sparkfunX/Qwiic_RF/README.md

# Qwiic_RF
LoRa Radio for the Qwiic System
