sparkfunX/Qwiic_RF/Hardware/Production/ordering_instructions.txt

panel size, 135x109mm
PCB thickness, 0.8mm
number of layers, 2
soldermask color, Black
silkscreen color, White
oz copper, 1oz
finish, HASL lead free
stencils, top
pcs per panel, 4
