sparkfunX/Qwiic_RF/Hardware/Test_Platform/Production/ordering_instructions.txt

panel size, 91x91mm
PCB thickness, 1.6mm
number of layers, 2
soldermask color, Black
silkscreen color, White
oz copper, 1oz
finish, HASL lead free
stencils, top+bottom
