sparkfunX/Qwiic_RF/Hardware/Test_Platform/README.md

** Test Platform for Qwiic LoRa **

This is essentially the prototype Qwiic LoRa hardware with only a U.FL connector for testing modular antennas for integration.
