sparkfunX/Qwiic_RF/Hardware/Qwiic_LoRa.pdf

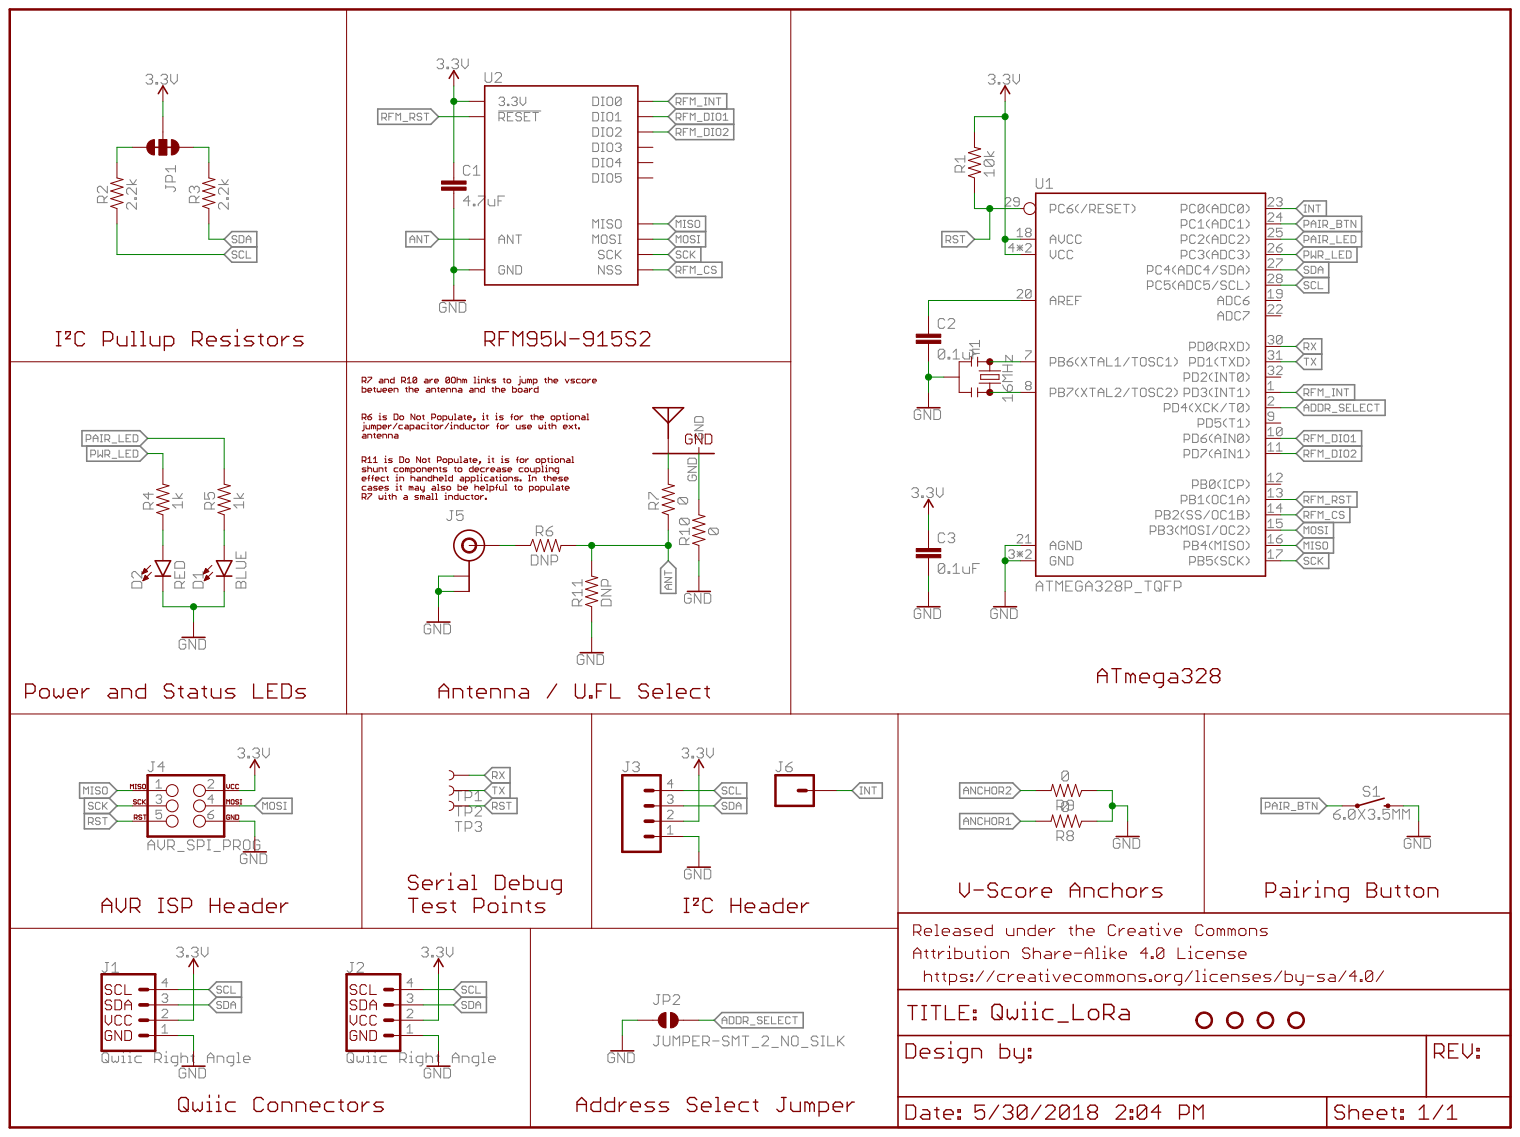
[picture p1: page 1]
