sparkfunX/Qwiic_RF/Hardware/Qwiic_LoRa.brd

## EAGLE design Hardware/Qwiic_LoRa.brd (2018-06-28)

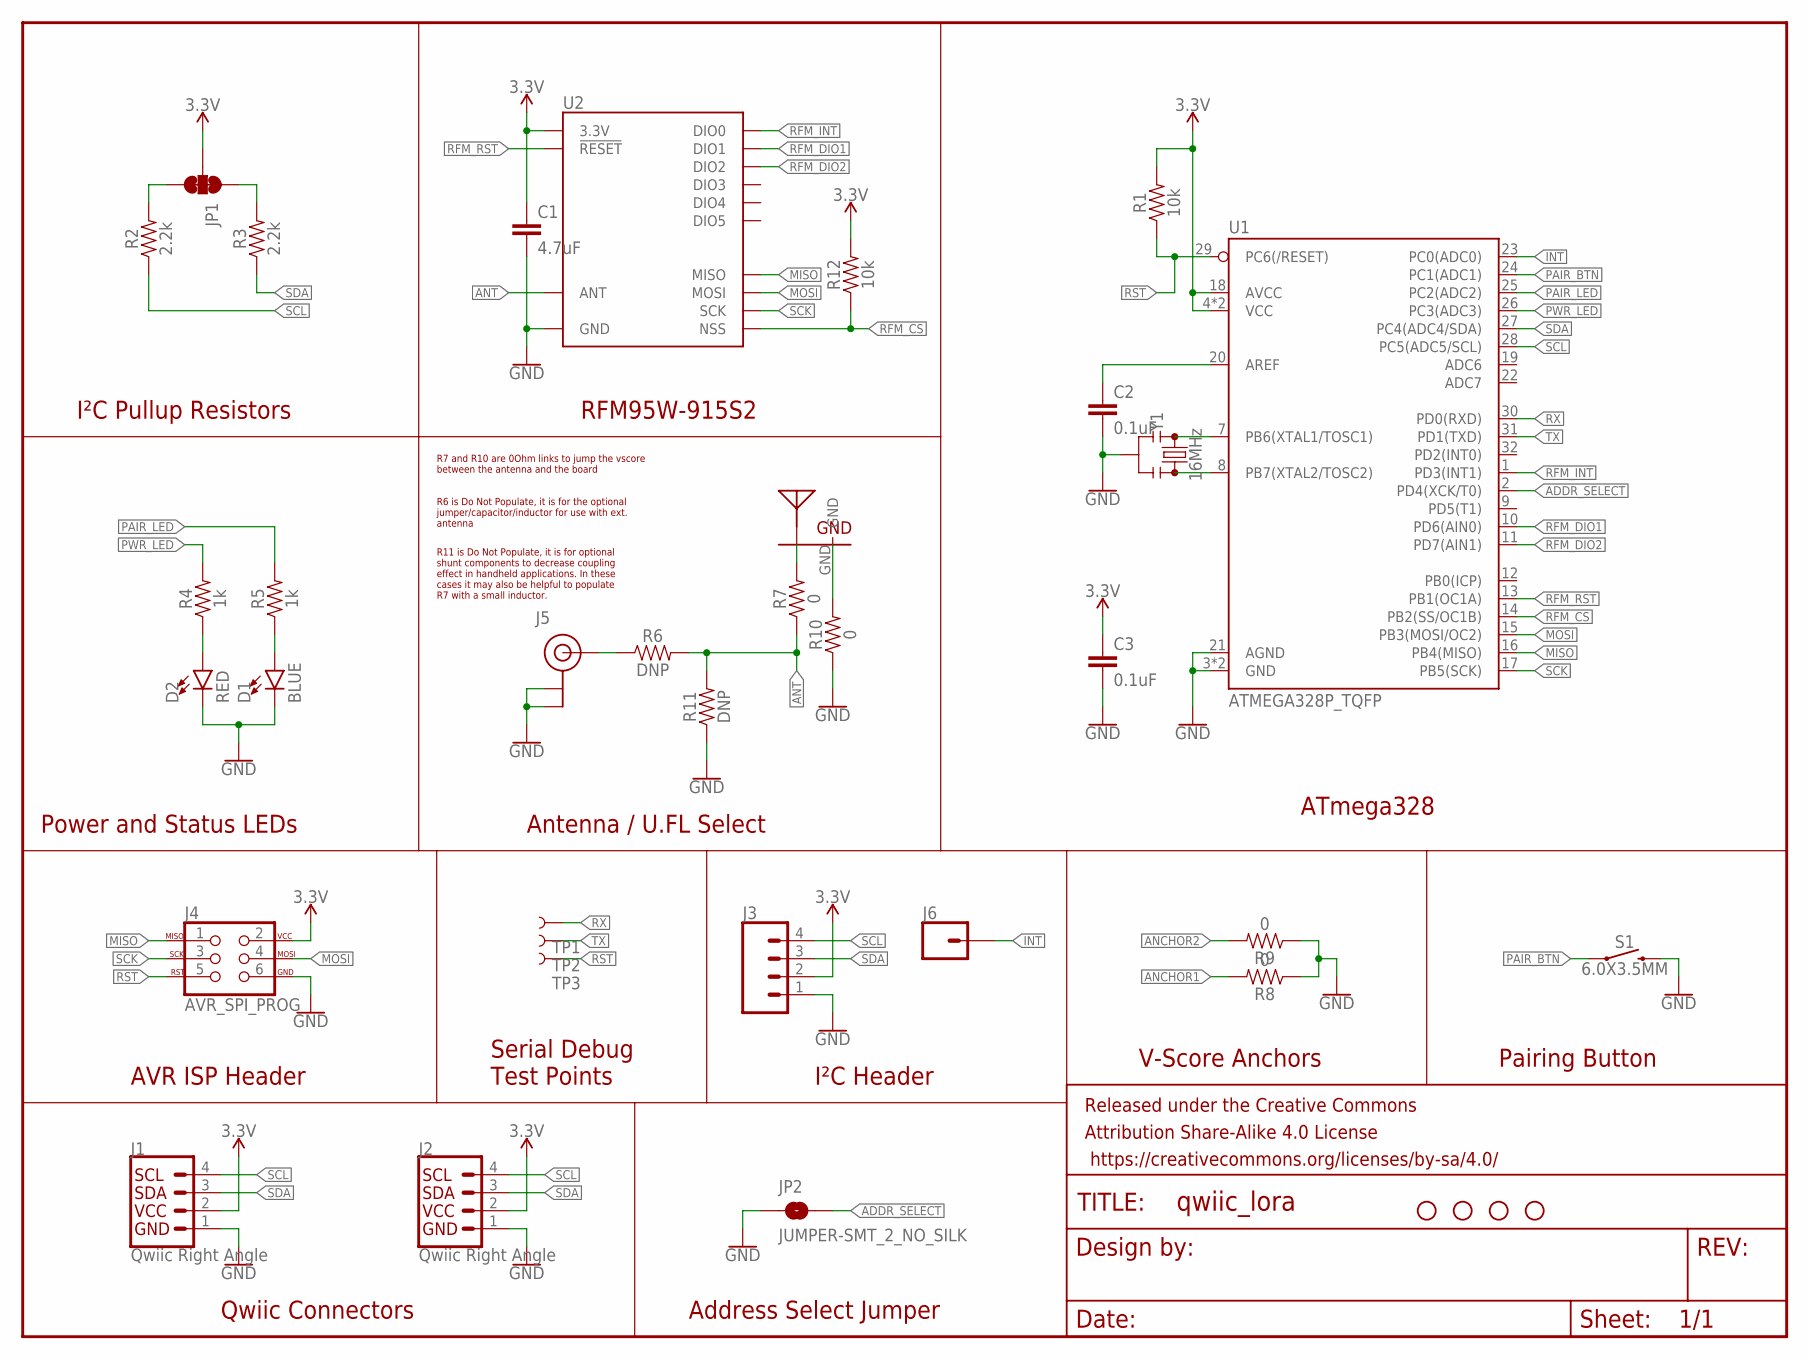
[picture p2: schematic Qwiic_LoRa.sch]

Parts:
C1: 4.7uF; 0603
C2, C3: 0.1uF; 0603
D1: BLUE; LED-0603
D2: RED; LED-0603
FRAME1: FRAME-LETTER; CREATIVE_COMMONS
H1, H2, H3, H4: STAND-OFF
J1, J2: Qwiic Right Angle; 1X04_1MM_RA
J3: CONN_041X04_NO_SILK; 1X04_NO_SILK
J4: AVR_SPI_PROG; 2X3_TEST_POINTS
J5: U.FL
J6: CONN_01PTH_NO_SILK_YES_STOP; 1X01_NO_SILK
JP1: JUMPER-SMT_3_2-NC_TRACE_SILK; SMT-JUMPER_3_2-NC_TRACE_SILK
JP2: JUMPER-SMT_2_NO_SILK; SMT-JUMPER_2_NO_SILK
R1, R12: 10k; 0603
R2, R3: 2.2k; 0603
R4, R5: 1k; 0603
R6, R11: DNP; 0603
R7, R8, R9, R10: 0; 0603
S1: 6.0X3.5MM; TACTILE_SWITCH_SMD_6.0X3.5MM
TP1, TP2, TP3: TEST-POINT3; PAD.03X.03
U1: ATMEGA328P_TQFP; TQFP32-08
U2: RFM96W; RFM95/96/97/98W
U$1: ANTENNA_915MHZ_INVERTED_F; ANTENNA_INVERTED_F_915MHZ
Y1: 16MHz; RESONATOR-SMD-3.2X1.3

Connections:
3.3V: C1.1, C3.1, J1.2, J2.2, J3.2, J4.2, JP1.2, R1.2, R12.2, U1.4 (VCC), U1.6 (VCC), U1.18 (AVCC), U2.3.3V
ADDR_SELECT: JP2.2, U1.2 (PD4(XCK/T0))
ANCHOR1: R8.2
ANCHOR2: R9.2
ANT: R6.2, R7.1, R11.2, U2.ANT
GND: C1.2, C2.2, C3.2, D1.C, D2.C, J1.1, J2.1, J3.1, J4.6, J5.1 (GND), J5.2 (GND), JP2.1, R8.1, R9.1, R10.1, R11.1, S1.2, U1.3 (GND), U1.5 (GND), U1.21 (AGND), U2.GND@1 (GND), U2.GND@2 (GND), U2.GND@3 (GND), Y1.2
INT: J6.1, U1.23 (PC0(ADC0))
MISO: J4.1, U1.16 (PB4(MISO)), U2.MISO
MOSI: J4.4, U1.15 (PB3(MOSI/OC2)), U2.MOSI
unnamed: D2.A, R4.1
unnamed: D1.A, R5.1
unnamed: C2.1, U1.20 (AREF)
unnamed: U1.7 (PB6(XTAL1/TOSC1)), Y1.1
unnamed: U1.8 (PB7(XTAL2/TOSC2)), Y1.3
unnamed: R7.2, U$1.FEED
unnamed: JP1.1, R3.2
unnamed: JP1.3, R2.2
unnamed: J5.FEED (SIGNAL), R6.1
unnamed: R10.2, U$1.GND
PAIR_BTN: S1.1, U1.24 (PC1(ADC1))
PAIR_LED: R5.2, U1.25 (PC2(ADC2))
PWR_LED: R4.2, U1.26 (PC3(ADC3))
RFM_CS: R12.1, U1.14 (PB2(SS/OC1B)), U2.NSS
RFM_DIO1: U1.10 (PD6(AIN0)), U2.DIO1
RFM_DIO2: U1.11 (PD7(AIN1)), U2.DIO2
RFM_INT: U1.1 (PD3(INT1)), U2.DIO0
RFM_RST: U1.13 (PB1(OC1A)), U2.!RESET
RST: J4.5, R1.1, TP3.P$1, U1.29 (PC6(/RESET))
RX: TP1.P$1, U1.30 (PD0(RXD))
SCK: J4.3, U1.17 (PB5(SCK)), U2.SCK
SCL: J1.4, J2.4, J3.4, R2.1, U1.28 (PC5(ADC5/SCL))
SDA: J1.3, J2.3, J3.3, R3.1, U1.27 (PC4(ADC4/SDA))
TX: TP2.P$1, U1.31 (PD1(TXD))

Notes on the sheet:
ATmega328
RFM95W-915S2
I²C Pullup Resistors
Antenna / U.FL Select
Power and Status LEDs
Qwiic Connectors
I²C Header
V-Score Anchors
Pairing Button
AVR ISP Header
Address Select Jumper
R7 and R10 are 0Ohm links to jump the vscore between the antenna and the board
R6 is Do Not Populate, it is for the optional jumper/capacitor/inductor for use with ext. antenna
R11 is Do Not Populate, it is for optional shunt components to decrease coupling effect in handheld applications. In these cases it may also be helpful to populate R7 with a small inductor.
Serial Debug Test Points

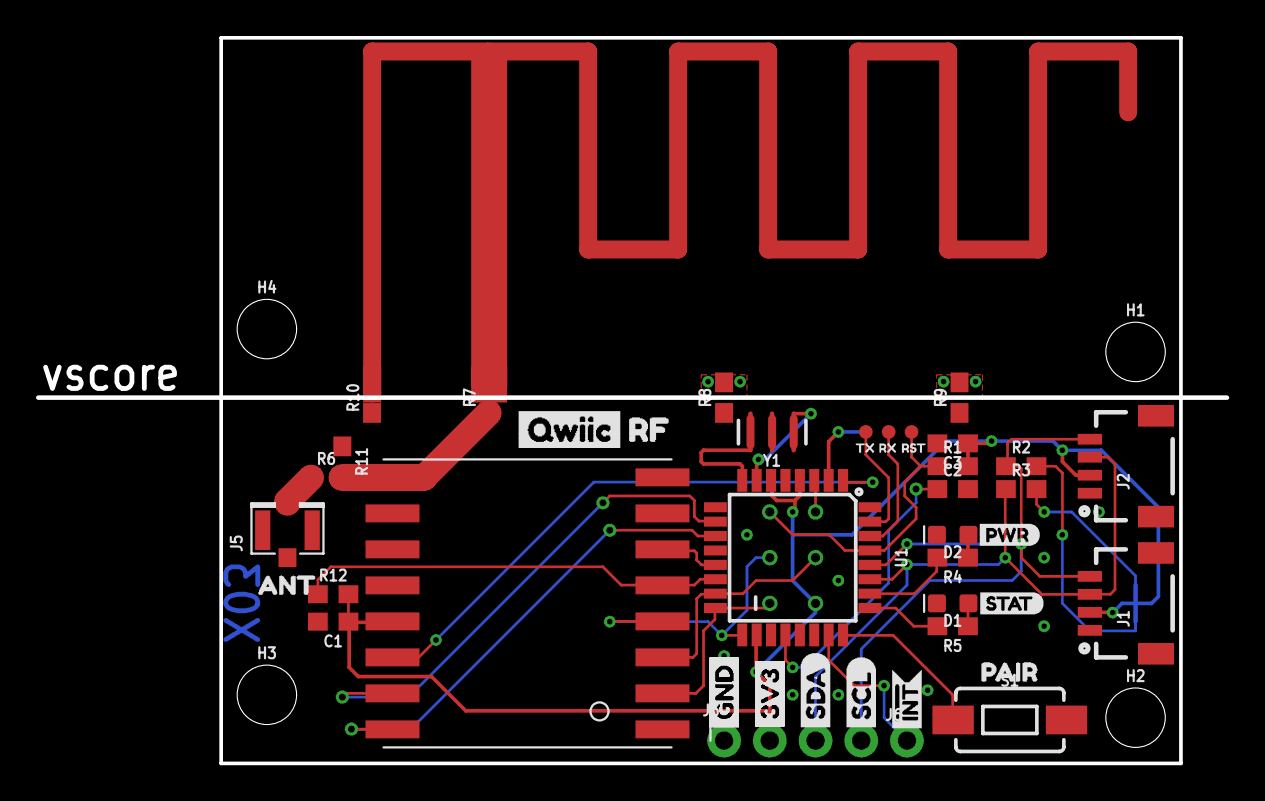
[picture p3: board Qwiic_LoRa.brd from above]

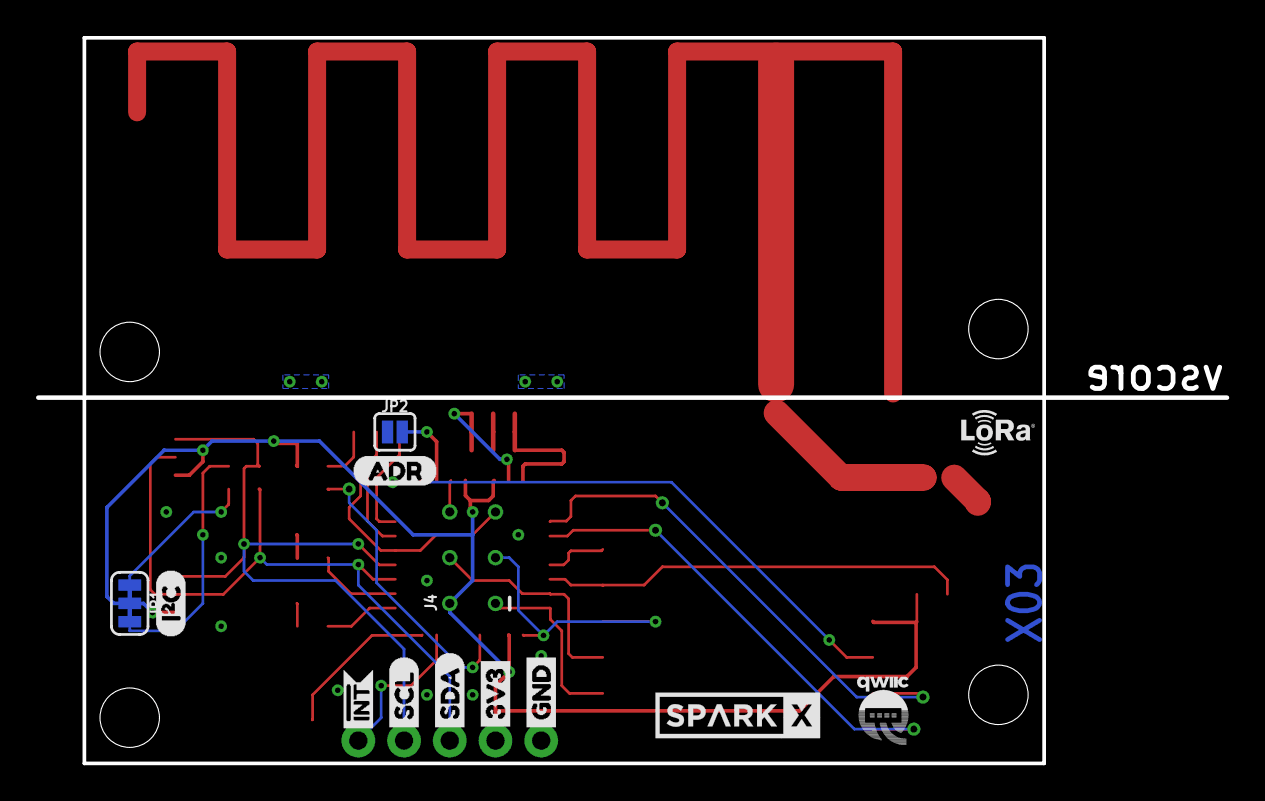
[picture p4: board Qwiic_LoRa.brd from below]

Board: 2 copper layers, 53.3 x 40.3 mm, 65 parts (13 on the bottom side), 31 nets.

Other parts of the board:
U$2: ANT0
U$3: PAIR1
U$4, U$22: SDA-[)
U$5, U$23: SCL-[)
U$6, U$18, U$19: GND-04
U$7, U$20, U$21: 3V3-04
U$8: PWR1
U$9: STAT2
U$10: QWIIC-LOGO-SMALL
U$11: TX1
U$12, U$24: INT#-[<
U$13: SPARKX-MEDIUM
U$14: ADR-()
U$15: RF1
U$16: QWIIC0
U$17: LORA_MARK#PNG
U$25: I_SUPER2_C-()-04
U$26: PRODUCTION_INSTRUCTIONS
U$27: RX0
U$28: RST2
