sparkfunX/Qwiic_RF/Hardware/Antennas/StubTrace/StubTrace_Antenna.brd

## EAGLE design Hardware/Antennas/StubTrace/StubTrace_Antenna.brd (2018-04-12)

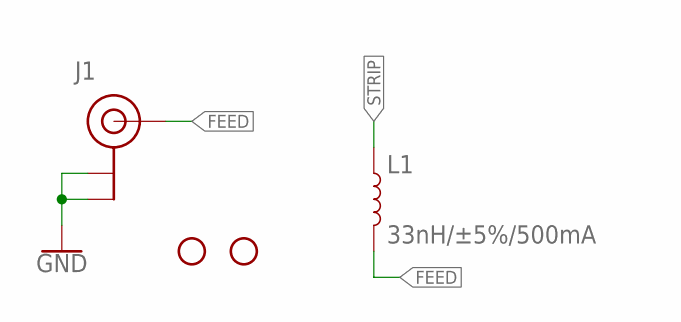
[picture p5: schematic StubTrace_Antenna.sch]

Parts:
H1, H2: STAND-OFF
J1: U.FL
L1: 33nH/±5%/500mA; 0603

Connections:
FEED: J1.FEED (SIGNAL), L1.2
GND: J1.1 (GND), J1.2 (GND)
STRIP: L1.1

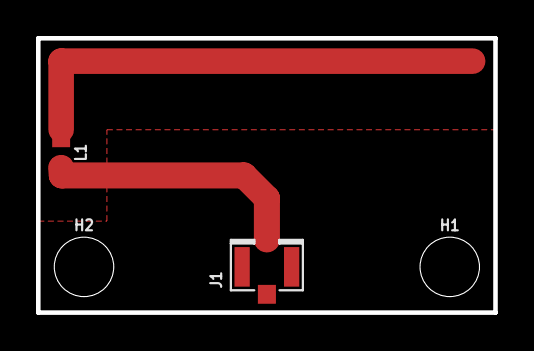
[picture p6: board StubTrace_Antenna.brd from above]

Board: 2 copper layers, 25.4 x 15.2 mm, 4 parts (0 on the bottom side), 2 nets.
