sparkfunX/Qwiic_RF/Hardware/Antennas/InvertedF/InvertedF_Antenna.brd

## EAGLE design Hardware/Antennas/InvertedF/InvertedF_Antenna.brd (2018-04-12)

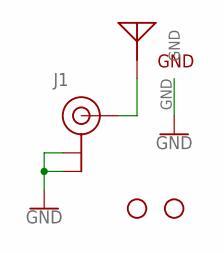
[picture p7: schematic InvertedF_Antenna.sch]

Parts:
H1, H2: STAND-OFF
J1: U.FL
U$1: ANTENNA_915MHZ_INVERTED_F; ANTENNA_INVERTED_F_915MHZ

Connections:
FEED: J1.FEED (SIGNAL), U$1.FEED
GND: J1.1 (GND), J1.2 (GND), U$1.GND

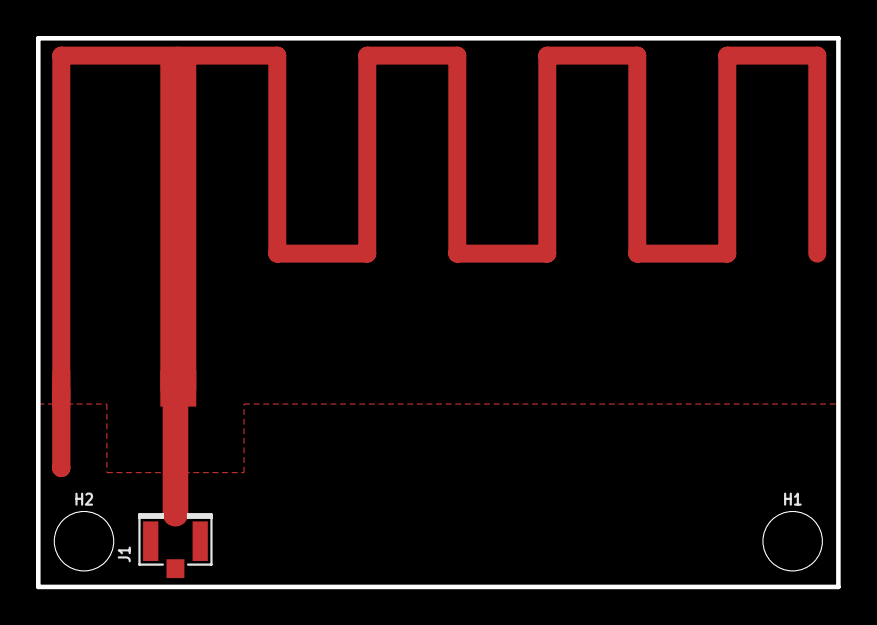
[picture p8: board InvertedF_Antenna.brd from above]

Board: 2 copper layers, 44.5 x 30.5 mm, 4 parts (0 on the bottom side), 2 nets.
