sparkfunX/Qwiic_RF/Hardware/Test_Platform/Qwiic_RF.brd

## EAGLE design Hardware/Test_Platform/Qwiic_RF.brd (2018-04-12)

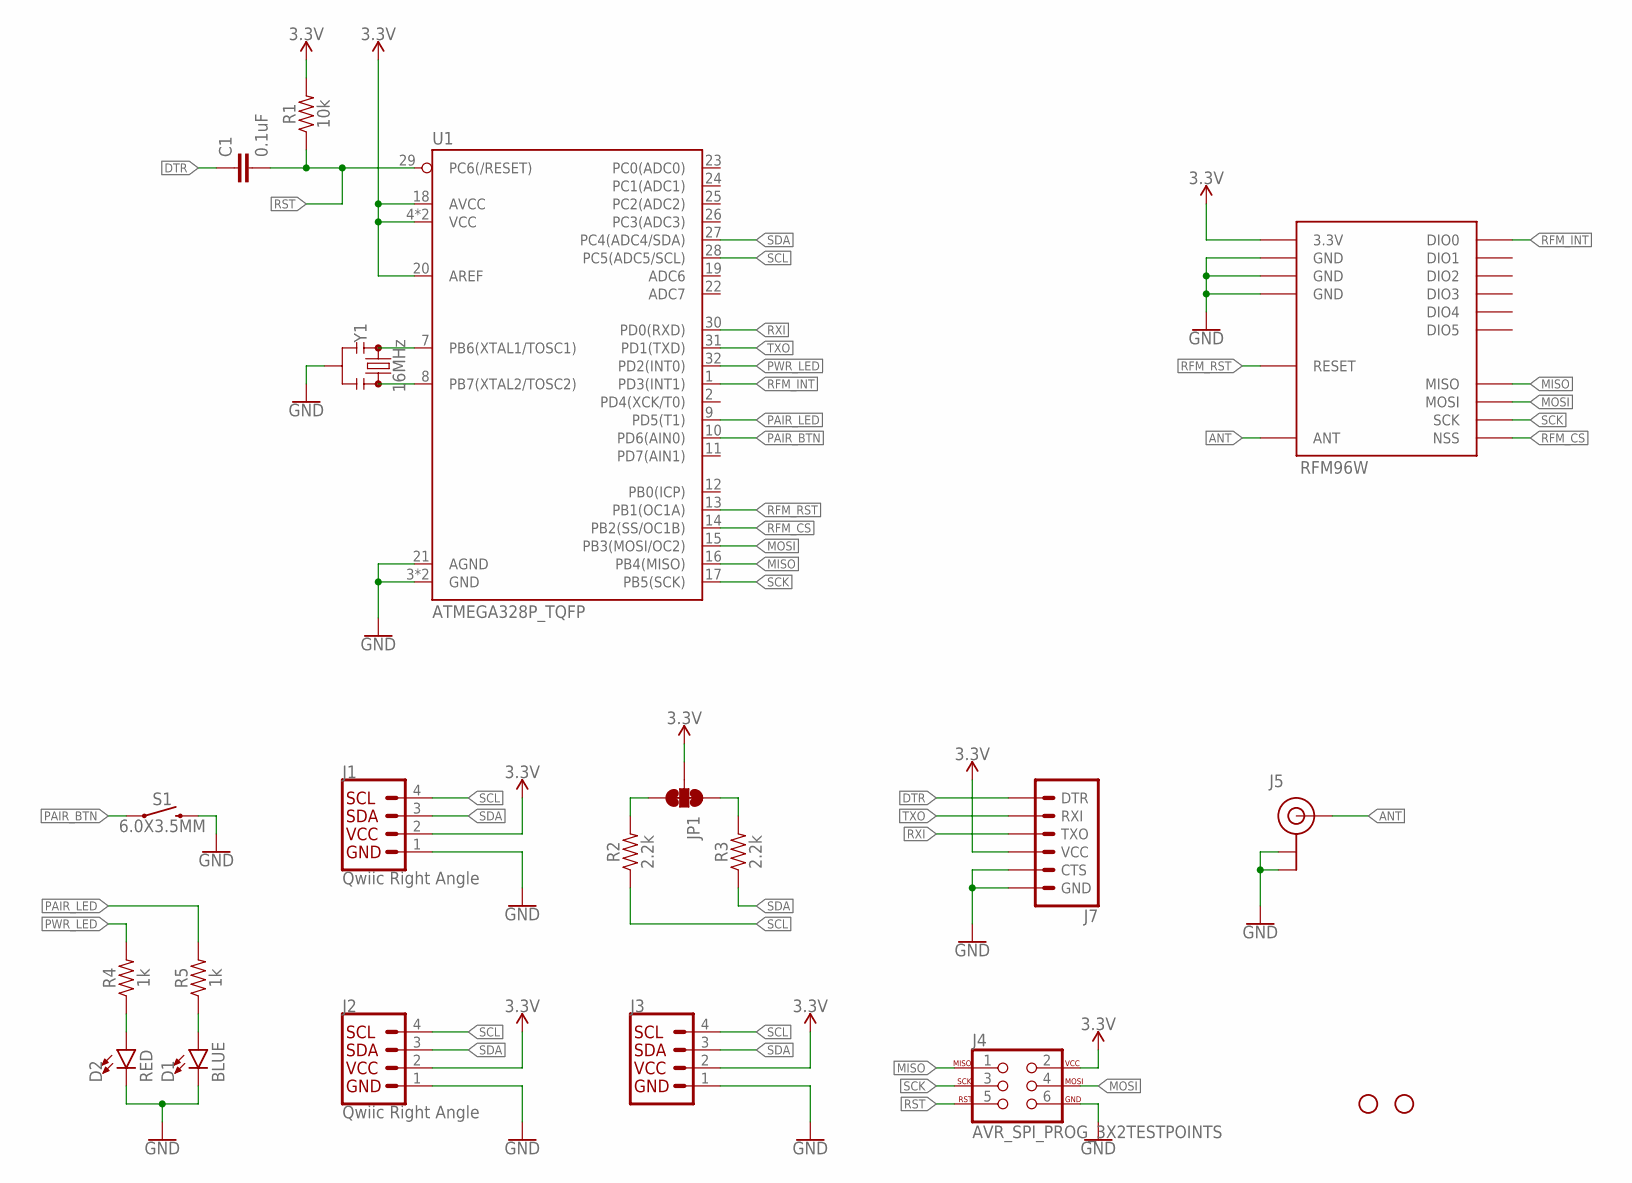
[picture p9: schematic Qwiic_RF.sch]

Parts:
C1: 0.1uF; 0603
D1: BLUE; LED-0603
D2: RED; LED-0603
H1, H2: STAND-OFF
J1, J2: Qwiic Right Angle; 1X04_1MM_RA
J3: I2C_STANDARD; 1X04
J4: AVR_SPI_PROG_3X2TESTPOINTS; 2X3_TEST_POINTS
J5: U.FL
J7: 6_PIN_SERIAL_TARGET; 1X06
JP1: JUMPER-SMT_3_2-NC_TRACE_SILK; SMT-JUMPER_3_2-NC_TRACE_SILK
R1: 10k; 0603
R2, R3: 2.2k; 0603
R4, R5: 1k; 0603
RFM96W: RFM96W; RFM95/96/97/98W
S1: 6.0X3.5MM; TACTILE_SWITCH_SMD_6.0X3.5MM
U1: ATMEGA328P_TQFP; TQFP32-08
Y1: 16MHz; RESONATOR-SMD-3.2X1.3

Connections:
3.3V: J1.2, J2.2, J3.2, J4.2, J7.4 (VCC), JP1.2, R1.2, RFM96W.3.3V, U1.4 (VCC), U1.6 (VCC), U1.18 (AVCC), U1.20 (AREF)
ANT: J5.FEED (SIGNAL), RFM96W.ANT
DTR: C1.1, J7.1 (DTR)
GND: D1.C, D2.C, J1.1, J2.1, J3.1, J4.6, J5.1 (GND), J5.2 (GND), J7.5 (CTS), J7.6 (GND), RFM96W.GND@1 (GND), RFM96W.GND@2 (GND), RFM96W.GND@3 (GND), S1.2, U1.3 (GND), U1.5 (GND), U1.21 (AGND), Y1.2
MISO: J4.1, RFM96W.MISO, U1.16 (PB4(MISO))
MOSI: J4.4, RFM96W.MOSI, U1.15 (PB3(MOSI/OC2))
unnamed: D2.A, R4.1
unnamed: D1.A, R5.1
unnamed: U1.7 (PB6(XTAL1/TOSC1)), Y1.1
unnamed: U1.8 (PB7(XTAL2/TOSC2)), Y1.3
unnamed: JP1.1, R3.2
unnamed: JP1.3, R2.2
PAIR_BTN: S1.1, U1.10 (PD6(AIN0))
PAIR_LED: R5.2, U1.9 (PD5(T1))
PWR_LED: R4.2, U1.32 (PD2(INT0))
RFM_CS: RFM96W.NSS, U1.14 (PB2(SS/OC1B))
RFM_INT: RFM96W.DIO0, U1.1 (PD3(INT1))
RFM_RST: RFM96W.RESET, U1.13 (PB1(OC1A))
RST: C1.2, J4.5, R1.1, U1.29 (PC6(/RESET))
RXI: J7.3 (TXO), U1.30 (PD0(RXD))
SCK: J4.3, RFM96W.SCK, U1.17 (PB5(SCK))
SCL: J1.4, J2.4, J3.4, R2.1, U1.28 (PC5(ADC5/SCL))
SDA: J1.3, J2.3, J3.3, R3.1, U1.27 (PC4(ADC4/SDA))
TXO: J7.2 (RXI), U1.31 (PD1(TXD))

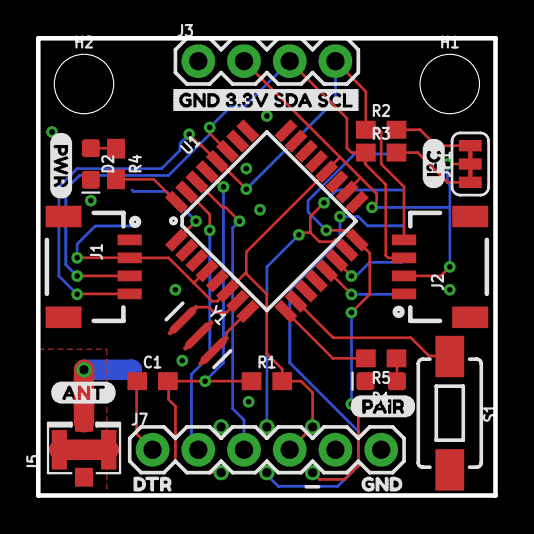
[picture p10: board Qwiic_RF.brd from above]

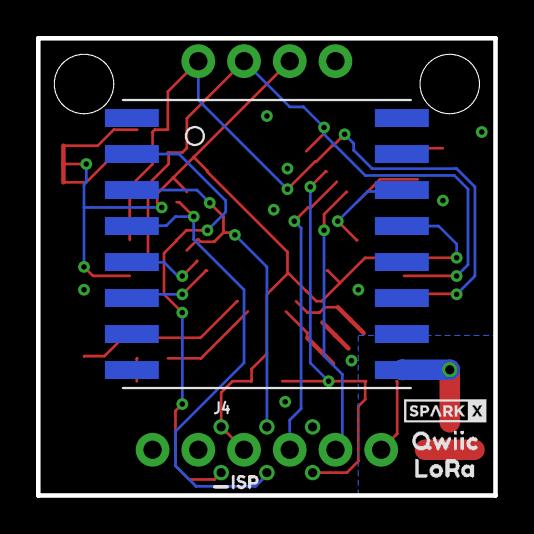
[picture p11: board Qwiic_RF.brd from below]

Board: 2 copper layers, 25.4 x 25.4 mm, 32 parts (6 on the bottom side), 24 nets.

Other parts of the board:
U$1: ANT5
U$2: DTR3
U$3: GND4
U$4: GND_3#3V_SDA_SCL6
U$5: I#C2
U$6: PAIR1
U$7: PWR0
U$8: SPARKX-TINY
U$9: QWIIC0
U$10: LORA1
U$11: ISP0
