sparkfunX/Qwiic_RF/Hardware/Antennas/OnBoardStampedMetal/OnBoardStampedMetal_Antenna.brd

## EAGLE design Hardware/Antennas/OnBoardStampedMetal/OnBoardStampedMetal_Antenna.brd (2018-04-12)

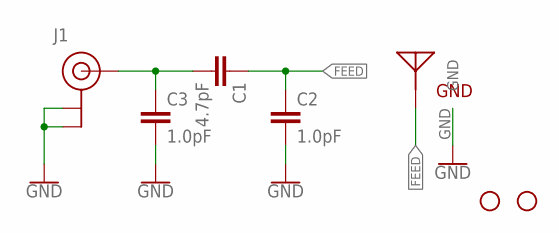
[picture p12: schematic OnBoardStampedMetal_Antenna.sch]

Parts:
C1: 4.7pF; 0603
C2, C3: 1.0pF; 0603
H1, H2: STAND-OFF
J1: U.FL
U$1: ONBOARD_SMD_STAMPED

Connections:
FEED: C1.1, C2.1, U$1.FEED
GND: C2.2, C3.2, J1.1 (GND), J1.2 (GND), U$1.GND
unnamed: C1.2, C3.1, J1.FEED (SIGNAL)

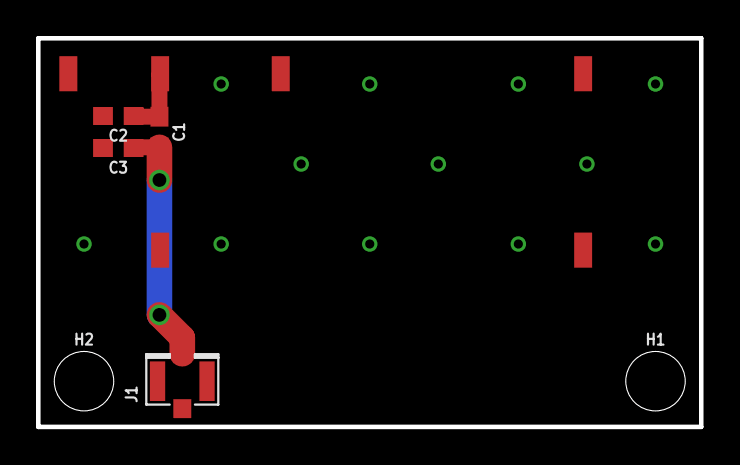
[picture p13: board OnBoardStampedMetal_Antenna.brd from above]

Board: 2 copper layers, 36.8 x 21.6 mm, 7 parts (0 on the bottom side), 3 nets.
