sparkfunX/Qwiic_RF/Hardware/Production/Qwiic_LoRa-Panel.brd

## EAGLE design Hardware/Production/Qwiic_LoRa-Panel.brd (2018-06-28)

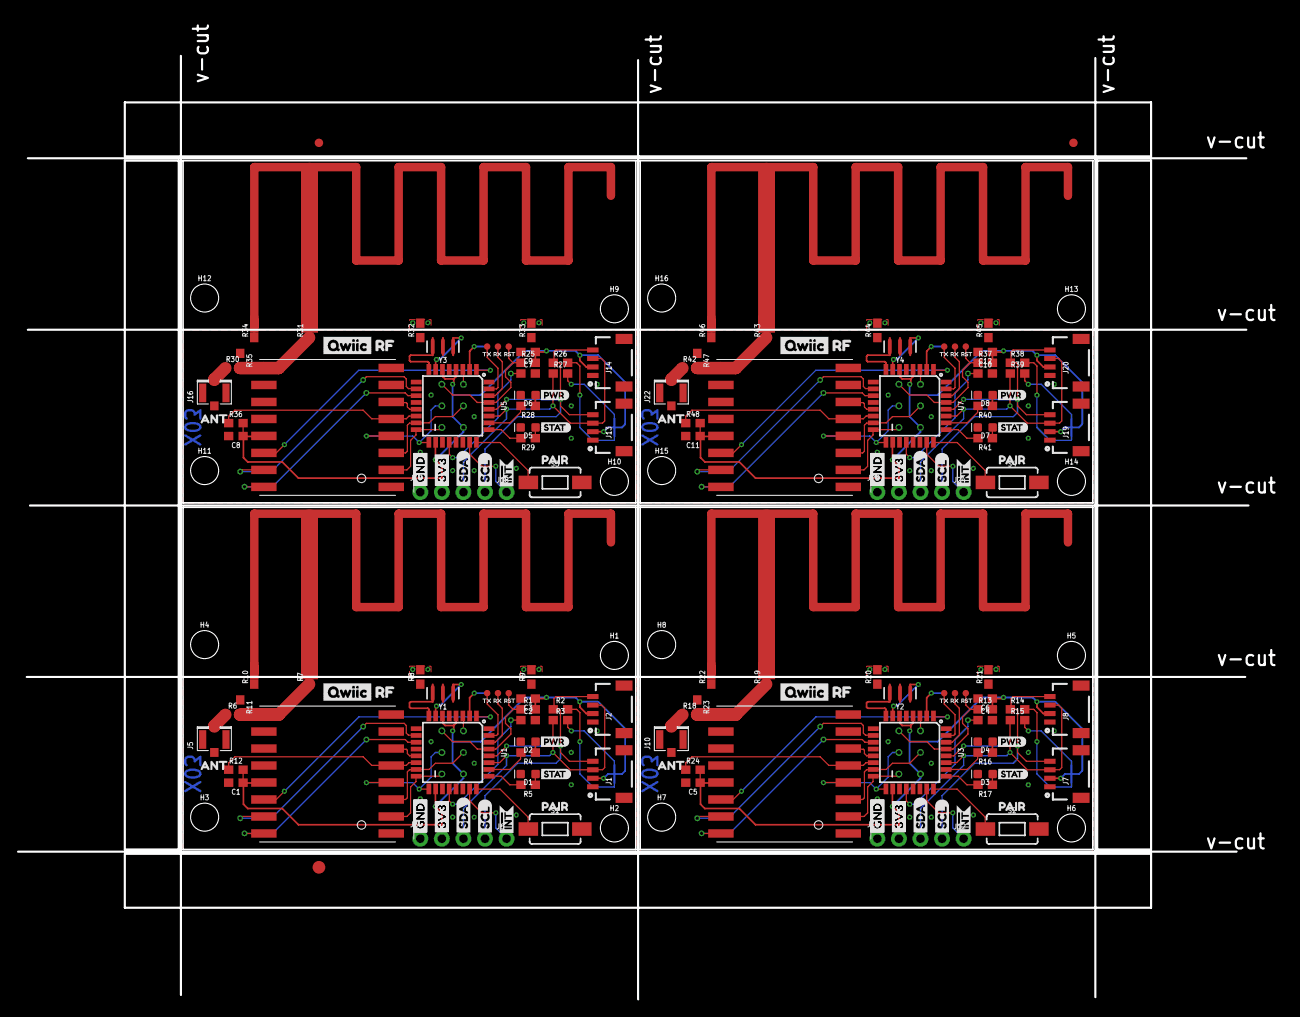
[picture p14: board Qwiic_LoRa-Panel.brd from above]

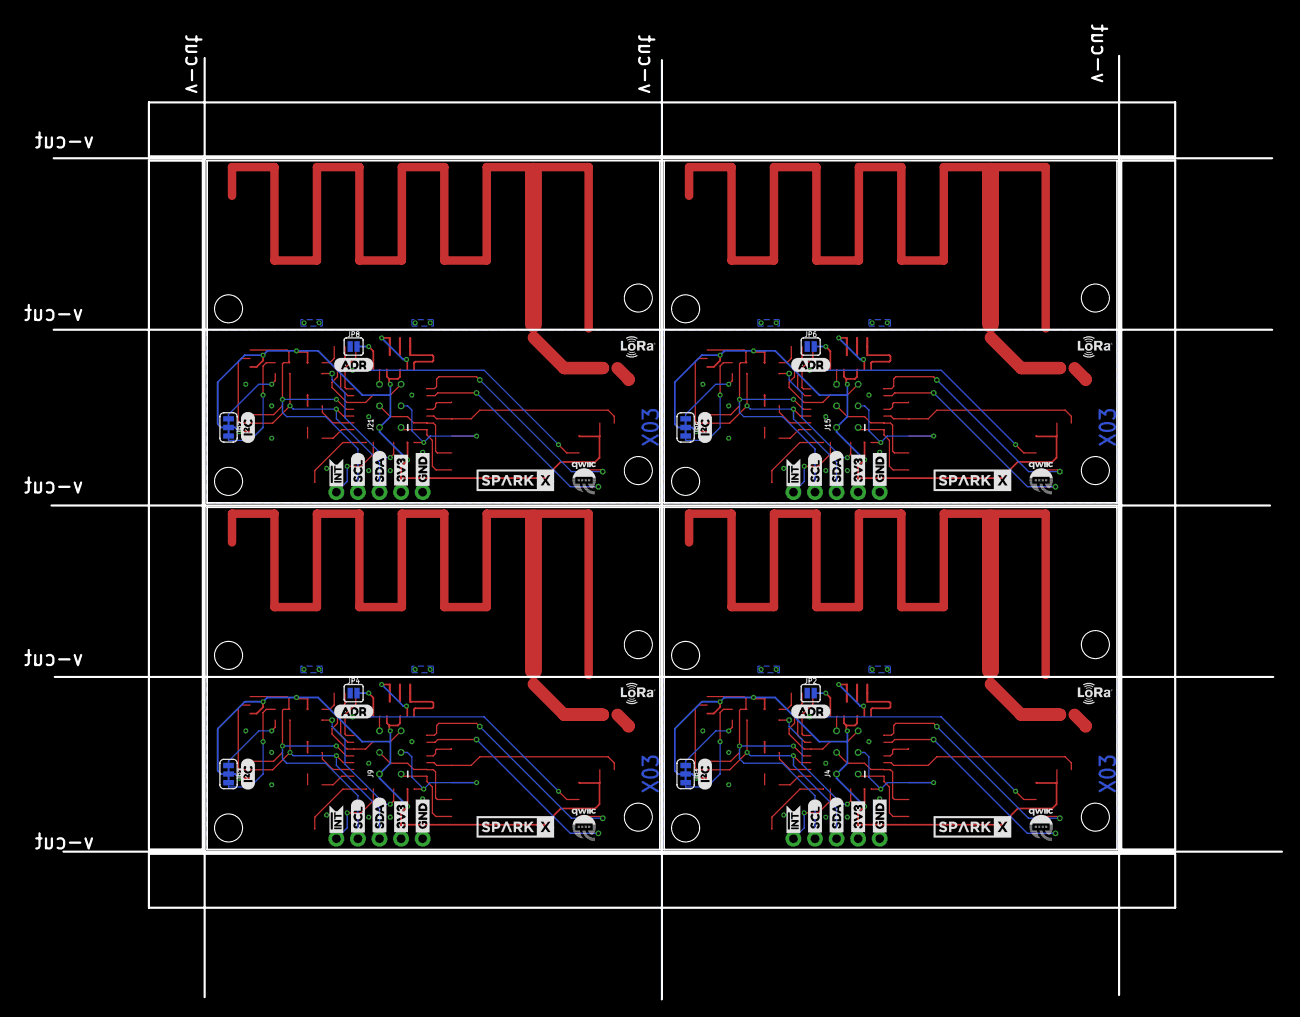
[picture p15: board Qwiic_LoRa-Panel.brd from below]

Board: 2 copper layers, 144.9 x 111.1 mm, 255 parts (52 on the bottom side), 124 nets.

Parts:
C1, C5, C8, C11: 4.7uF; 0603
C2, C3, C4, C6, C7, C9, C10, C12: 0.1uF; 0603
D1, D3, D5, D7: BLUE; LED-0603
D2, D4, D6, D8: RED; LED-0603
E$1, E$2: FIDUCIAL-1X2
E$3: FIDUCIAL-1.5X3
H1, H2, H3, H4, H5, H6, H7, H8, H9, H10, H11, H12, H13, H14, H15, H16: STAND-OFF
J1, J2, J7, J8, J13, J14, J19, J20: Qwiic Right Angle; 1X04_1MM_RA
J3, J11, J17, J23: 1X04_NO_SILK
J4, J9, J15, J21: AVR_SPI_PROG; 2X3_TEST_POINTS
J5, J10, J16, J22: U.FL
J6, J12, J18, J24: 1X01_NO_SILK
JP1, JP3, JP5, JP7: SMT-JUMPER_3_2-NC_TRACE_SILK
JP2, JP4, JP6, JP8: JUMPER-SMT_2_NO_SILK; SMT-JUMPER_2_NO_SILK
R1, R12, R13, R24, R25, R36, R37, R48: 10k; 0603
R2, R3, R14, R15, R26, R27, R38, R39: 2.2k; 0603
R4, R5, R16, R17, R28, R29, R40, R41: 1k; 0603
R6, R11, R18, R23, R30, R35, R42, R47: DNP; 0603
R7, R8, R9, R10, R19, R20, R21, R22, R31, R32, R33, R34, R43, R44, R45, R46: 0; 0603
S1, S2, S3, S4: 6.0X3.5MM; TACTILE_SWITCH_SMD_6.0X3.5MM
TP1, TP2, TP3, TP4, TP5, TP6, TP7, TP8, TP9, TP10, TP11, TP12: PAD.03X.03
U1, U3, U5, U7: ATMEGA328P_TQFP; TQFP32-08
U2, U4, U6, U8: RFM96W; RFM95/96/97/98W
U$1, U$26, U$55, U$82: ANTENNA_915MHZ_INVERTED_F; ANTENNA_INVERTED_F_915MHZ
U$2, U$50, U$77, U$104: ANT0
U$3, U$51, U$78, U$105: PAIR1
U$4, U$22, U$29, U$42, U$56, U$69, U$83, U$96: SDA-[)
U$5, U$23, U$30, U$43, U$57, U$70, U$84, U$97: SCL-[)
U$6, U$18, U$19, U$31, U$38, U$39, U$58, U$65, U$66, U$85, U$92, U$93: GND-04
U$7, U$20, U$21, U$32, U$40, U$41, U$59, U$67, U$68, U$86, U$94, U$95: 3V3-04
U$8, U$33, U$60, U$87: PWR1
U$9, U$34, U$61, U$88: STAT2
U$10, U$48, U$75, U$102: QWIIC-LOGO-SMALL
U$11, U$52, U$79, U$106: TX1
U$12, U$24, U$37, U$44, U$64, U$71, U$91, U$98: INT#-[<
U$13, U$36, U$63, U$90: SPARKX-MEDIUM
U$14, U$45, U$72, U$99: ADR-()
U$15, U$47, U$74, U$101: RF1
U$16, U$35, U$62, U$89: QWIIC0
U$17, U$49, U$76, U$103: LORA_MARK#PNG
U$25, U$46, U$73, U$100: I_SUPER2_C-()-04
U$27, U$53, U$80, U$107: RX0
U$28, U$54, U$81, U$108: RST2
Y1, Y2, Y3, Y4: 16MHz; RESONATOR-SMD-3.2X1.3

Connections:
3.3V: C1.1, C3.1, J1.2, J2.2, J3.2, J4.2, JP1.2, R1.2, R12.2, U1.4, U1.6, U1.18, U2.3.3V
3.3V1: C5.1, C6.1, J7.2, J8.2, J9.2, J11.2, JP3.2, R13.2, R24.2, U3.4, U3.6, U3.18, U4.3.3V
3.3V2: C8.1, C9.1, J13.2, J14.2, J15.2, J17.2, JP5.2, R25.2, R36.2, U5.4, U5.6, U5.18, U6.3.3V
3.3V3: C11.1, C12.1, J19.2, J20.2, J21.2, J23.2, JP7.2, R37.2, R48.2, U7.4, U7.6, U7.18, U8.3.3V
ADDR_SELECT: JP2.2, U1.2
ADDR_SELECT1: JP4.2, U3.2
ADDR_SELECT2: JP6.2, U5.2
ADDR_SELECT3: JP8.2, U7.2
ANT: R6.2, R7.1, R11.2, U2.ANT
ANT1: R18.2, R19.1, R23.2, U4.ANT
ANT2: R30.2, R31.1, R35.2, U6.ANT
ANT3: R42.2, R43.1, R47.2, U8.ANT
GND: C1.2, C2.2, C3.2, D1.C, D2.C, J1.1, J2.1, J3.1, J4.6, J5.1, J5.2, JP2.1, R8.1, R9.1, R10.1, R11.1, S1.2, U1.3, U1.5, U1.21, U2.GND@1, U2.GND@2, U2.GND@3, Y1.2
GND1: C4.2, C5.2, C6.2, D3.C, D4.C, J7.1, J8.1, J9.6, J10.1, J10.2, J11.1, JP4.1, R20.1, R21.1, R22.1, R23.1, S2.2, U3.3, U3.5, U3.21, U4.GND@1, U4.GND@2, U4.GND@3, Y2.2
GND2: C7.2, C8.2, C9.2, D5.C, D6.C, J13.1, J14.1, J15.6, J16.1, J16.2, J17.1, JP6.1, R32.1, R33.1, R34.1, R35.1, S3.2, U5.3, U5.5, U5.21, U6.GND@1, U6.GND@2, U6.GND@3, Y3.2
GND3: C10.2, C11.2, C12.2, D7.C, D8.C, J19.1, J20.1, J21.6, J22.1, J22.2, J23.1, JP8.1, R44.1, R45.1, R46.1, R47.1, S4.2, U7.3, U7.5, U7.21, U8.GND@1, U8.GND@2, U8.GND@3, Y4.2
INT: J6.1, U1.23
INT1: J12.1, U3.23
INT2: J18.1, U5.23
INT3: J24.1, U7.23
MISO: J4.1, U1.16, U2.MISO
MISO1: J9.1, U3.16, U4.MISO
MISO2: J15.1, U5.16, U6.MISO
MISO3: J21.1, U7.16, U8.MISO
MOSI: J4.4, U1.15, U2.MOSI
MOSI1: J9.4, U3.15, U4.MOSI
MOSI2: J15.4, U5.15, U6.MOSI
MOSI3: J21.4, U7.15, U8.MOSI
unnamed: D2.A, R4.1
unnamed: D1.A, R5.1
unnamed: C2.1, U1.20
unnamed: U1.7, Y1.1
unnamed: U1.8, Y1.3
unnamed: R7.2, U$1.FEED
unnamed: JP1.1, R3.2
unnamed: JP1.3, R2.2
unnamed: J5.FEED, R6.1
unnamed: U3.7, Y2.1
unnamed: R10.2, U$1.GND
unnamed: U3.8, Y2.3
unnamed: JP3.1, R15.2
unnamed: JP3.3, R14.2
unnamed: D4.A, R16.1
unnamed: D3.A, R17.1
unnamed: J10.FEED, R18.1
unnamed: C4.1, U3.20
unnamed: R19.2, U$26.FEED
unnamed: R22.2, U$26.GND
unnamed: U5.7, Y3.1
unnamed: U5.8, Y3.3
unnamed: JP5.1, R27.2
unnamed: JP5.3, R26.2
unnamed: D6.A, R28.1
unnamed: D5.A, R29.1
unnamed: J16.FEED, R30.1
unnamed: C7.1, U5.20
unnamed: R31.2, U$55.FEED
unnamed: R34.2, U$55.GND
unnamed: U7.7, Y4.1
unnamed: U7.8, Y4.3
unnamed: JP7.1, R39.2
unnamed: JP7.3, R38.2
unnamed: D8.A, R40.1
unnamed: D7.A, R41.1
unnamed: J22.FEED, R42.1
unnamed: C10.1, U7.20
unnamed: R43.2, U$82.FEED
unnamed: R46.2, U$82.GND
PAIR_BTN: S1.1, U1.24
PAIR_BTN1: S2.1, U3.24
PAIR_BTN2: S3.1, U5.24
PAIR_BTN3: S4.1, U7.24
PAIR_LED: R5.2, U1.25
PAIR_LED1: R17.2, U3.25
PAIR_LED2: R29.2, U5.25
PAIR_LED3: R41.2, U7.25
PWR_LED: R4.2, U1.26
PWR_LED1: R16.2, U3.26
PWR_LED2: R28.2, U5.26
PWR_LED3: R40.2, U7.26
RFM_CS: R12.1, U1.14, U2.NSS
RFM_CS1: R24.1, U3.14, U4.NSS
RFM_CS2: R36.1, U5.14, U6.NSS
RFM_CS3: R48.1, U7.14, U8.NSS
RFM_DIO1: U1.10, U2.DIO1
RFM_DIO2: U1.11, U2.DIO2
RFM_DIO3: U3.10, U4.DIO1
RFM_DIO4: U3.11, U4.DIO2
RFM_DIO5: U5.10, U6.DIO1
RFM_DIO6: U5.11, U6.DIO2
RFM_DIO7: U7.10, U8.DIO1
RFM_DIO8: U7.11, U8.DIO2
RFM_INT: U1.1, U2.DIO0
RFM_INT1: U3.1, U4.DIO0
RFM_INT2: U5.1, U6.DIO0
RFM_INT3: U7.1, U8.DIO0
RFM_RST: U1.13, U2.!RESET
RFM_RST1: U3.13, U4.!RESET
RFM_RST2: U5.13, U6.!RESET
RFM_RST3: U7.13, U8.!RESET
RST: J4.5, R1.1, TP3.P$1, U1.29
RST1: J9.5, R13.1, TP6.P$1, U3.29
RST2: J15.5, R25.1, TP9.P$1, U5.29
RST3: J21.5, R37.1, TP12.P$1, U7.29
RX: TP1.P$1, U1.30
RX1: TP4.P$1, U3.30
RX2: TP7.P$1, U5.30
RX3: TP10.P$1, U7.30
SCK: J4.3, U1.17, U2.SCK
SCK1: J9.3, U3.17, U4.SCK
SCK2: J15.3, U5.17, U6.SCK
SCK3: J21.3, U7.17, U8.SCK
SCL: J1.4, J2.4, J3.4, R2.1, U1.28
SCL1: J7.4, J8.4, J11.4, R14.1, U3.28
SCL2: J13.4, J14.4, J17.4, R26.1, U5.28
SCL3: J19.4, J20.4, J23.4, R38.1, U7.28
SDA: J1.3, J2.3, J3.3, R3.1, U1.27
SDA1: J7.3, J8.3, J11.3, R15.1, U3.27
SDA2: J13.3, J14.3, J17.3, R27.1, U5.27
SDA3: J19.3, J20.3, J23.3, R39.1, U7.27
TX: TP2.P$1, U1.31
TX1: TP5.P$1, U3.31
TX2: TP8.P$1, U5.31
TX3: TP11.P$1, U7.31
