sparkfunX/Qwiic_RF/Hardware/Antennas/EthertronicsStampedMetal/EthertronicsStampedMetal_Antenna.brd

## EAGLE design Hardware/Antennas/EthertronicsStampedMetal/EthertronicsStampedMetal_Antenna.brd (2018-04-12)

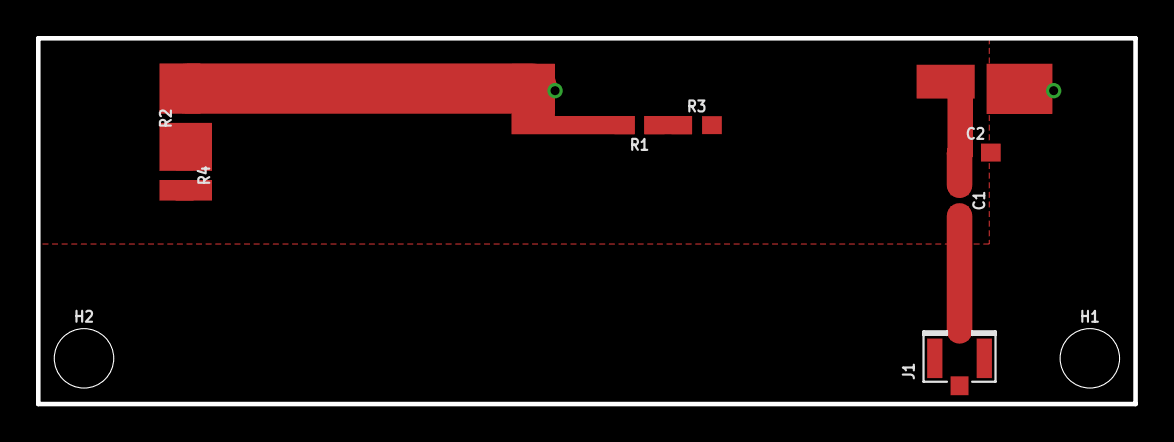
[picture p16: board EthertronicsStampedMetal_Antenna.brd from above]

Board: 2 copper layers, 61.0 x 20.3 mm, 10 parts (0 on the bottom side), 6 nets.

Parts:
C1: 4.7pF; 0603
C2: 1.0pF; 0603
H1, H2: STAND-OFF
J1: U.FL
R1, R2, R3, R4: 0; 0603
U$1: ETHERTRONICS_STAMPED_ANTENNA; ETHERTRONICS_ISM_STAMPED

Connections:
FEED: C1.1, C2.1, U$1.FEED
GND: C2.2, J1.1, J1.2, U$1.GND
unnamed: C1.2, J1.FEED
unnamed: R2.1, R4.1
unnamed: R1.1, R3.1
STRIP: R1.2, R4.2
