sparkfunX/Qwiic_RF/Hardware/Test_Platform/Production/Qwiic_RF-Panel.brd

## EAGLE design Hardware/Test_Platform/Production/Qwiic_RF-Panel.brd (2018-04-12)

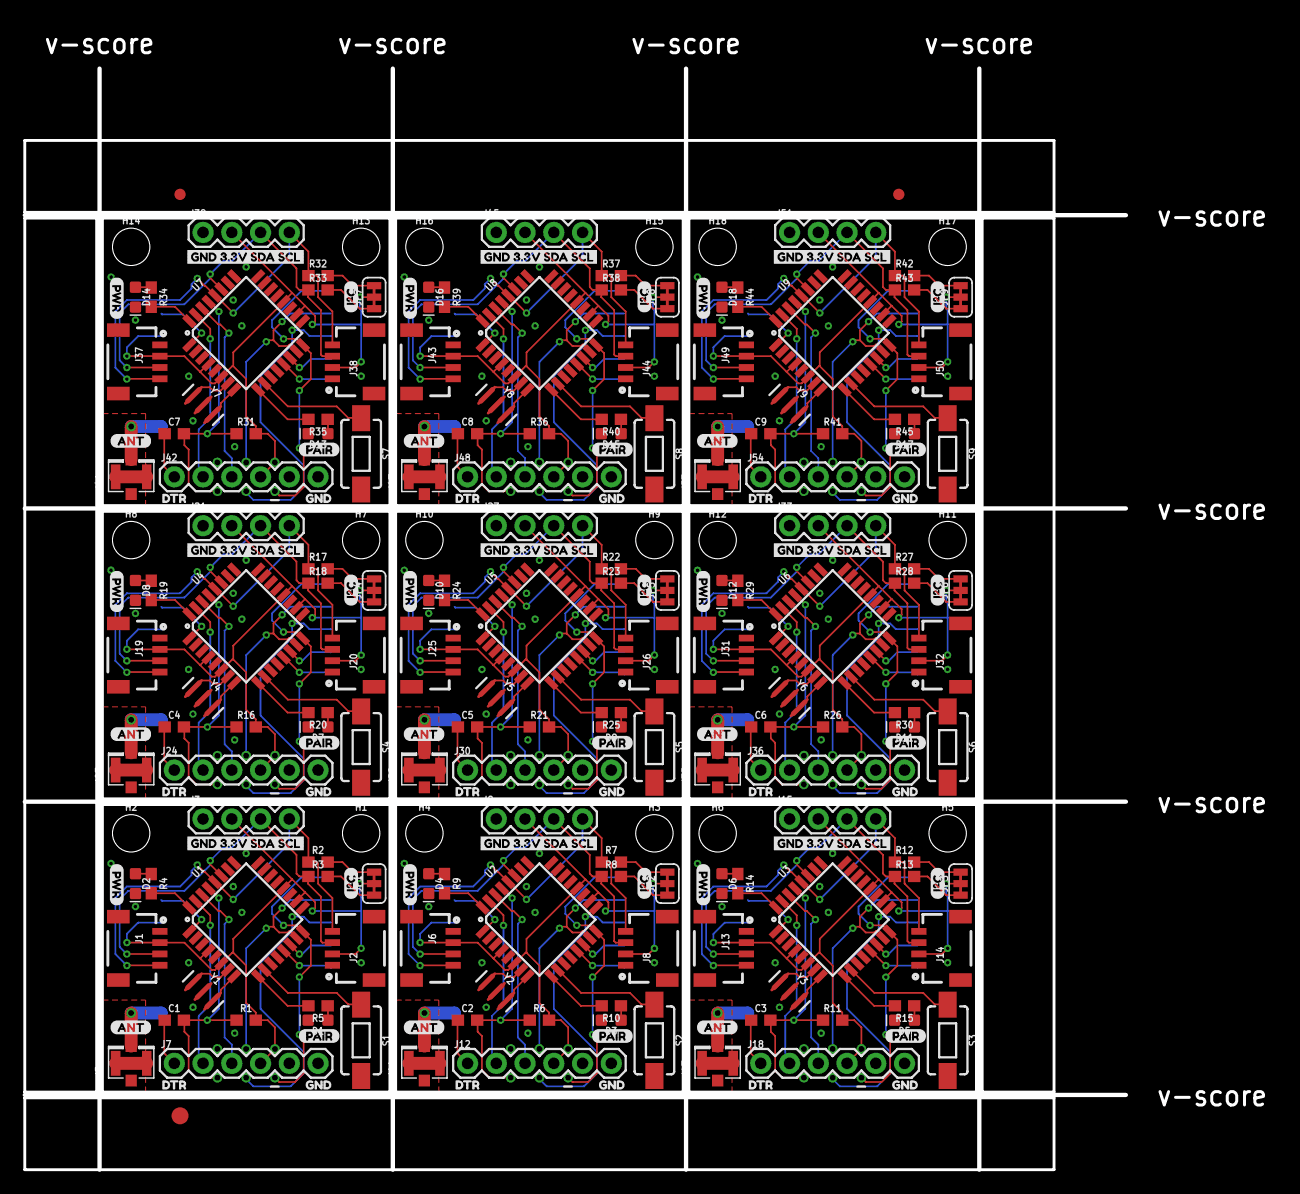
[picture p17: board Qwiic_RF-Panel.brd from above]

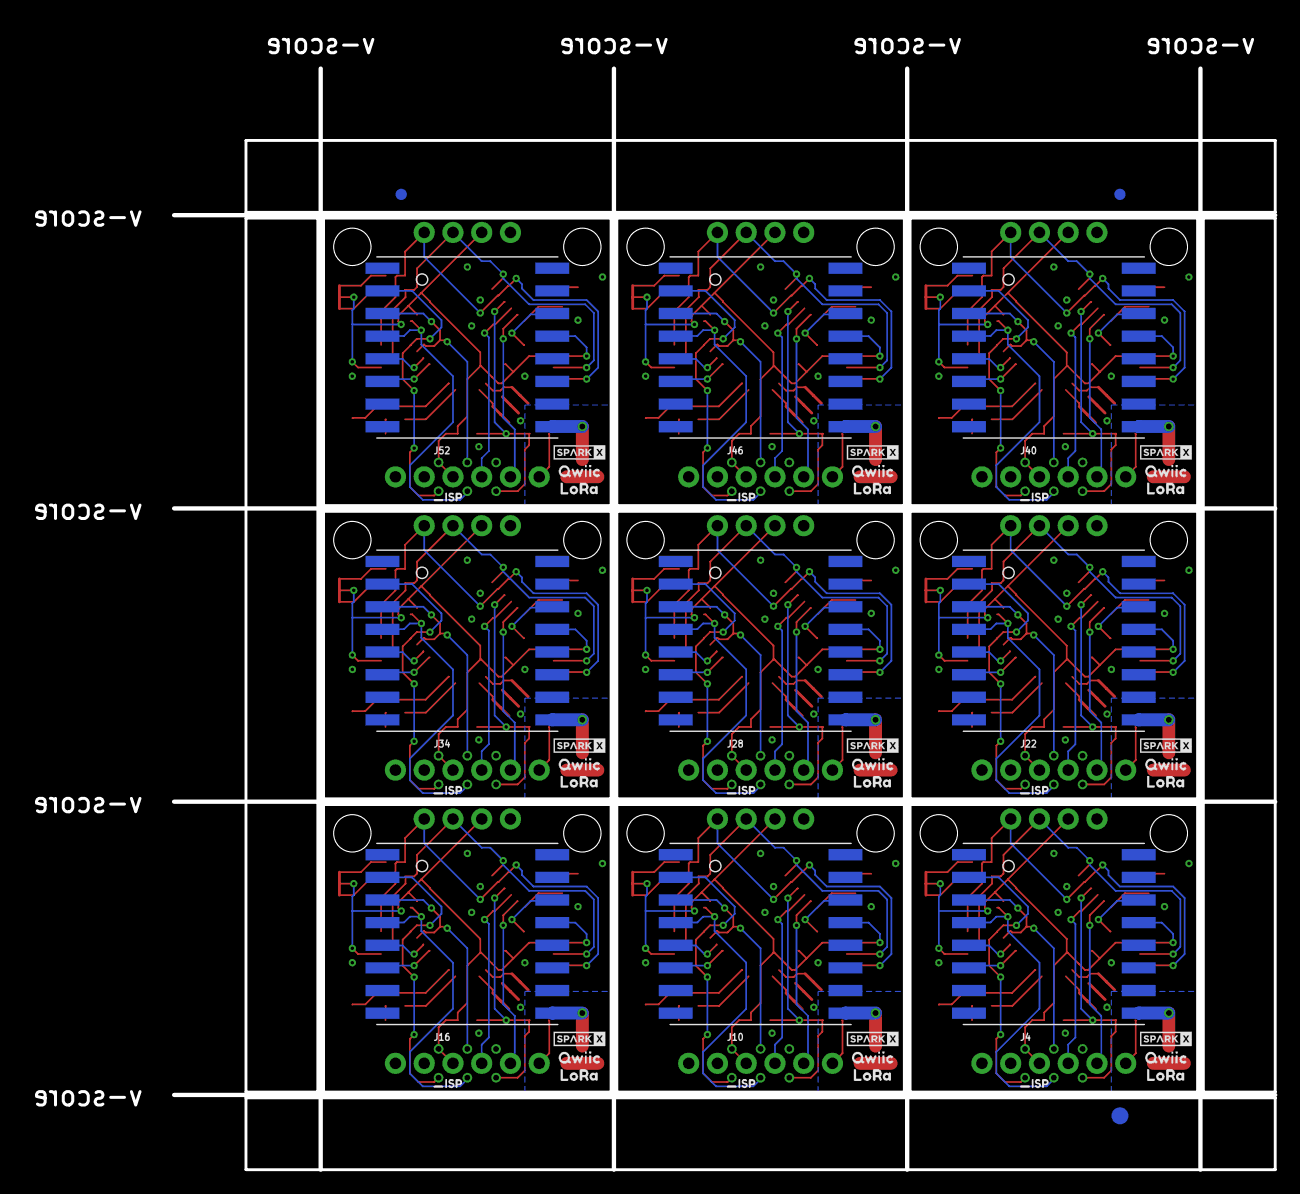
[picture p18: board Qwiic_RF-Panel.brd from below]

Board: 2 copper layers, 97.3 x 97.3 mm, 294 parts (57 on the bottom side), 216 nets.

Parts:
C1, C2, C3, C4, C5, C6, C7, C8, C9: 0.1uF; 0603
D1, D3, D5, D7, D9, D11, D13, D15, D17: BLUE; LED-0603
D2, D4, D6, D8, D10, D12, D14, D16, D18: RED; LED-0603
E$1, E$2, E$3, E$4: FIDUCIAL-1X2
E$5, E$6: FIDUCIAL-1.5X3
H1, H2, H3, H4, H5, H6, H7, H8, H9, H10, H11, H12, H13, H14, H15, H16, H17, H18: STAND-OFF
J1, J2, J6, J8, J13, J14, J19, J20, J25, J26, J31, J32, J37, J38, J43, J44, J49, J50: Qwiic Right Angle; 1X04_1MM_RA
J3, J9, J15, J21, J27, J33, J39, J45, J51: 1X04
J4, J10, J16, J22, J28, J34, J40, J46, J52: AVR_SPI_PROG_3X2TESTPOINTS; 2X3_TEST_POINTS
J5, J11, J17, J23, J29, J35, J41, J47, J53: U.FL
J7, J12, J18, J24, J30, J36, J42, J48, J54: 1X06
JP1, JP2, JP3, JP4, JP5, JP6, JP7, JP8, JP9: SMT-JUMPER_3_2-NC_TRACE_SILK
R1, R6, R11, R16, R21, R26, R31, R36, R41: 10k; 0603
R2, R3, R7, R8, R12, R13, R17, R18, R22, R23, R27, R28, R32, R33, R37, R38, R42, R43: 2.2k; 0603
R4, R5, R9, R10, R14, R15, R19, R20, R24, R25, R29, R30, R34, R35, R39, R40, R44, R45: 1k; 0603
RFM96W, RFM96W1, RFM96W2, RFM96W3, RFM96W4, RFM96W5, RFM96W6, RFM96W7, RFM96W8: RFM96W; RFM95/96/97/98W
S1, S2, S3, S4, S5, S6, S7, S8, S9: 6.0X3.5MM; TACTILE_SWITCH_SMD_6.0X3.5MM
U1, U2, U3, U4, U5, U6, U7, U8, U9: ATMEGA328P_TQFP; TQFP32-08
U$1, U$12, U$23, U$34, U$45, U$56, U$67, U$78, U$89: ANT5
U$2, U$13, U$24, U$35, U$46, U$57, U$68, U$79, U$90: DTR3
U$3, U$14, U$25, U$36, U$47, U$58, U$69, U$80, U$91: GND4
U$4, U$15, U$26, U$37, U$48, U$59, U$70, U$81, U$92: GND_3#3V_SDA_SCL6
U$5, U$16, U$27, U$38, U$49, U$60, U$71, U$82, U$93: I#C2
U$6, U$17, U$28, U$39, U$50, U$61, U$72, U$83, U$94: PAIR1
U$7, U$18, U$29, U$40, U$51, U$62, U$73, U$84, U$95: PWR0
U$8, U$19, U$30, U$41, U$52, U$63, U$74, U$85, U$96: SPARKX-TINY
U$9, U$20, U$31, U$42, U$53, U$64, U$75, U$86, U$97: QWIIC0
U$10, U$21, U$32, U$43, U$54, U$65, U$76, U$87, U$98: LORA1
U$11, U$22, U$33, U$44, U$55, U$66, U$77, U$88, U$99: ISP0
Y1, Y2, Y3, Y4, Y5, Y6, Y7, Y8, Y9: 16MHz; RESONATOR-SMD-3.2X1.3

Connections:
3.3V: J1.2, J2.2, J3.2, J4.2, J7.4, JP1.2, R1.2, RFM96W.3.3V, U1.4, U1.6, U1.18, U1.20
3.3V1: J6.2, J8.2, J9.2, J10.2, J12.4, JP2.2, R6.2, RFM96W1.3.3V, U2.4, U2.6, U2.18, U2.20
3.3V2: J13.2, J14.2, J15.2, J16.2, J18.4, JP3.2, R11.2, RFM96W2.3.3V, U3.4, U3.6, U3.18, U3.20
3.3V3: J19.2, J20.2, J21.2, J22.2, J24.4, JP4.2, R16.2, RFM96W3.3.3V, U4.4, U4.6, U4.18, U4.20
3.3V4: J25.2, J26.2, J27.2, J28.2, J30.4, JP5.2, R21.2, RFM96W4.3.3V, U5.4, U5.6, U5.18, U5.20
3.3V5: J31.2, J32.2, J33.2, J34.2, J36.4, JP6.2, R26.2, RFM96W5.3.3V, U6.4, U6.6, U6.18, U6.20
3.3V6: J37.2, J38.2, J39.2, J40.2, J42.4, JP7.2, R31.2, RFM96W6.3.3V, U7.4, U7.6, U7.18, U7.20
3.3V7: J43.2, J44.2, J45.2, J46.2, J48.4, JP8.2, R36.2, RFM96W7.3.3V, U8.4, U8.6, U8.18, U8.20
3.3V8: J49.2, J50.2, J51.2, J52.2, J54.4, JP9.2, R41.2, RFM96W8.3.3V, U9.4, U9.6, U9.18, U9.20
ANT: J5.FEED, RFM96W.ANT
ANT1: J11.FEED, RFM96W1.ANT
ANT2: J17.FEED, RFM96W2.ANT
ANT3: J23.FEED, RFM96W3.ANT
ANT4: J29.FEED, RFM96W4.ANT
ANT5: J35.FEED, RFM96W5.ANT
ANT6: J41.FEED, RFM96W6.ANT
ANT7: J47.FEED, RFM96W7.ANT
ANT8: J53.FEED, RFM96W8.ANT
DTR: C1.1, J7.1
DTR1: C2.1, J12.1
DTR2: C3.1, J18.1
DTR3: C4.1, J24.1
DTR4: C5.1, J30.1
DTR5: C6.1, J36.1
DTR6: C7.1, J42.1
DTR7: C8.1, J48.1
DTR8: C9.1, J54.1
GND: D1.C, D2.C, J1.1, J2.1, J3.1, J4.6, J5.1, J5.2, J7.5, J7.6, RFM96W.GND@1, RFM96W.GND@2, RFM96W.GND@3, S1.2, U1.3, U1.5, U1.21, Y1.2
GND1: D3.C, D4.C, J6.1, J8.1, J9.1, J10.6, J11.1, J11.2, J12.5, J12.6, RFM96W1.GND@1, RFM96W1.GND@2, RFM96W1.GND@3, S2.2, U2.3, U2.5, U2.21, Y2.2
GND2: D5.C, D6.C, J13.1, J14.1, J15.1, J16.6, J17.1, J17.2, J18.5, J18.6, RFM96W2.GND@1, RFM96W2.GND@2, RFM96W2.GND@3, S3.2, U3.3, U3.5, U3.21, Y3.2
GND3: D7.C, D8.C, J19.1, J20.1, J21.1, J22.6, J23.1, J23.2, J24.5, J24.6, RFM96W3.GND@1, RFM96W3.GND@2, RFM96W3.GND@3, S4.2, U4.3, U4.5, U4.21, Y4.2
GND4: D9.C, D10.C, J25.1, J26.1, J27.1, J28.6, J29.1, J29.2, J30.5, J30.6, RFM96W4.GND@1, RFM96W4.GND@2, RFM96W4.GND@3, S5.2, U5.3, U5.5, U5.21, Y5.2
GND5: D11.C, D12.C, J31.1, J32.1, J33.1, J34.6, J35.1, J35.2, J36.5, J36.6, RFM96W5.GND@1, RFM96W5.GND@2, RFM96W5.GND@3, S6.2, U6.3, U6.5, U6.21, Y6.2
GND6: D13.C, D14.C, J37.1, J38.1, J39.1, J40.6, J41.1, J41.2, J42.5, J42.6, RFM96W6.GND@1, RFM96W6.GND@2, RFM96W6.GND@3, S7.2, U7.3, U7.5, U7.21, Y7.2
GND7: D15.C, D16.C, J43.1, J44.1, J45.1, J46.6, J47.1, J47.2, J48.5, J48.6, RFM96W7.GND@1, RFM96W7.GND@2, RFM96W7.GND@3, S8.2, U8.3, U8.5, U8.21, Y8.2
GND8: D17.C, D18.C, J49.1, J50.1, J51.1, J52.6, J53.1, J53.2, J54.5, J54.6, RFM96W8.GND@1, RFM96W8.GND@2, RFM96W8.GND@3, S9.2, U9.3, U9.5, U9.21, Y9.2
MISO: J4.1, RFM96W.MISO, U1.16
MISO1: J10.1, RFM96W1.MISO, U2.16
MISO2: J16.1, RFM96W2.MISO, U3.16
MISO3: J22.1, RFM96W3.MISO, U4.16
MISO4: J28.1, RFM96W4.MISO, U5.16
MISO5: J34.1, RFM96W5.MISO, U6.16
MISO6: J40.1, RFM96W6.MISO, U7.16
MISO7: J46.1, RFM96W7.MISO, U8.16
MISO8: J52.1, RFM96W8.MISO, U9.16
MOSI: J4.4, RFM96W.MOSI, U1.15
MOSI1: J10.4, RFM96W1.MOSI, U2.15
MOSI2: J16.4, RFM96W2.MOSI, U3.15
MOSI3: J22.4, RFM96W3.MOSI, U4.15
MOSI4: J28.4, RFM96W4.MOSI, U5.15
MOSI5: J34.4, RFM96W5.MOSI, U6.15
MOSI6: J40.4, RFM96W6.MOSI, U7.15
MOSI7: J46.4, RFM96W7.MOSI, U8.15
MOSI8: J52.4, RFM96W8.MOSI, U9.15
unnamed: D2.A, R4.1
unnamed: D1.A, R5.1
unnamed: U2.7, Y2.1
unnamed: U1.7, Y1.1
unnamed: U1.8, Y1.3
unnamed: U2.8, Y2.3
unnamed: JP1.1, R3.2
unnamed: JP1.3, R2.2
unnamed: JP2.1, R8.2
unnamed: JP2.3, R7.2
unnamed: D4.A, R9.1
unnamed: D3.A, R10.1
unnamed: U3.7, Y3.1
unnamed: U3.8, Y3.3
unnamed: JP3.1, R13.2
unnamed: JP3.3, R12.2
unnamed: D6.A, R14.1
unnamed: D5.A, R15.1
unnamed: U4.7, Y4.1
unnamed: U4.8, Y4.3
unnamed: JP4.1, R18.2
unnamed: JP4.3, R17.2
unnamed: D8.A, R19.1
unnamed: D7.A, R20.1
unnamed: U5.7, Y5.1
unnamed: U5.8, Y5.3
unnamed: JP5.1, R23.2
unnamed: JP5.3, R22.2
unnamed: D10.A, R24.1
unnamed: D9.A, R25.1
unnamed: U6.7, Y6.1
unnamed: U6.8, Y6.3
unnamed: JP6.1, R28.2
unnamed: JP6.3, R27.2
unnamed: D12.A, R29.1
unnamed: D11.A, R30.1
unnamed: U7.7, Y7.1
unnamed: U7.8, Y7.3
unnamed: JP7.1, R33.2
unnamed: JP7.3, R32.2
unnamed: D14.A, R34.1
unnamed: D13.A, R35.1
unnamed: U8.7, Y8.1
unnamed: U8.8, Y8.3
unnamed: JP8.1, R38.2
unnamed: JP8.3, R37.2
unnamed: D16.A, R39.1
unnamed: D15.A, R40.1
unnamed: U9.7, Y9.1
unnamed: U9.8, Y9.3
unnamed: JP9.1, R43.2
unnamed: JP9.3, R42.2
unnamed: D18.A, R44.1
unnamed: D17.A, R45.1
PAIR_BTN: S1.1, U1.10
PAIR_BTN1: S2.1, U2.10
PAIR_BTN2: S3.1, U3.10
PAIR_BTN3: S4.1, U4.10
PAIR_BTN4: S5.1, U5.10
PAIR_BTN5: S6.1, U6.10
PAIR_BTN6: S7.1, U7.10
PAIR_BTN7: S8.1, U8.10
PAIR_BTN8: S9.1, U9.10
PAIR_LED: R5.2, U1.9
PAIR_LED1: R10.2, U2.9
PAIR_LED2: R15.2, U3.9
PAIR_LED3: R20.2, U4.9
PAIR_LED4: R25.2, U5.9
PAIR_LED5: R30.2, U6.9
PAIR_LED6: R35.2, U7.9
PAIR_LED7: R40.2, U8.9
PAIR_LED8: R45.2, U9.9
PWR_LED: R4.2, U1.32
PWR_LED1: R9.2, U2.32
PWR_LED2: R14.2, U3.32
PWR_LED3: R19.2, U4.32
PWR_LED4: R24.2, U5.32
PWR_LED5: R29.2, U6.32
PWR_LED6: R34.2, U7.32
PWR_LED7: R39.2, U8.32
PWR_LED8: R44.2, U9.32
RFM_CS: RFM96W.NSS, U1.14
RFM_CS1: RFM96W1.NSS, U2.14
RFM_CS2: RFM96W2.NSS, U3.14
RFM_CS3: RFM96W3.NSS, U4.14
RFM_CS4: RFM96W4.NSS, U5.14
RFM_CS5: RFM96W5.NSS, U6.14
RFM_CS6: RFM96W6.NSS, U7.14
RFM_CS7: RFM96W7.NSS, U8.14
RFM_CS8: RFM96W8.NSS, U9.14
RFM_INT: RFM96W.DIO0, U1.1
RFM_INT1: RFM96W1.DIO0, U2.1
RFM_INT2: RFM96W2.DIO0, U3.1
RFM_INT3: RFM96W3.DIO0, U4.1
RFM_INT4: RFM96W4.DIO0, U5.1
RFM_INT5: RFM96W5.DIO0, U6.1
RFM_INT6: RFM96W6.DIO0, U7.1
RFM_INT7: RFM96W7.DIO0, U8.1
RFM_INT8: RFM96W8.DIO0, U9.1
RFM_RST: RFM96W.RESET, U1.13
RFM_RST1: RFM96W1.RESET, U2.13
RFM_RST2: RFM96W2.RESET, U3.13
RFM_RST3: RFM96W3.RESET, U4.13
RFM_RST4: RFM96W4.RESET, U5.13
RFM_RST5: RFM96W5.RESET, U6.13
RFM_RST6: RFM96W6.RESET, U7.13
RFM_RST7: RFM96W7.RESET, U8.13
RFM_RST8: RFM96W8.RESET, U9.13
RST: C1.2, J4.5, R1.1, U1.29
RST1: C2.2, J10.5, R6.1, U2.29
RST2: C3.2, J16.5, R11.1, U3.29
RST3: C4.2, J22.5, R16.1, U4.29
RST4: C5.2, J28.5, R21.1, U5.29
RST5: C6.2, J34.5, R26.1, U6.29
RST6: C7.2, J40.5, R31.1, U7.29
RST7: C8.2, J46.5, R36.1, U8.29
RST8: C9.2, J52.5, R41.1, U9.29
RXI: J7.3, U1.30
RXI1: J12.3, U2.30
RXI2: J18.3, U3.30
RXI3: J24.3, U4.30
RXI4: J30.3, U5.30
RXI5: J36.3, U6.30
RXI6: J42.3, U7.30
RXI7: J48.3, U8.30
RXI8: J54.3, U9.30
SCK: J4.3, RFM96W.SCK, U1.17
SCK1: J10.3, RFM96W1.SCK, U2.17
SCK2: J16.3, RFM96W2.SCK, U3.17
SCK3: J22.3, RFM96W3.SCK, U4.17
SCK4: J28.3, RFM96W4.SCK, U5.17
SCK5: J34.3, RFM96W5.SCK, U6.17
SCK6: J40.3, RFM96W6.SCK, U7.17
SCK7: J46.3, RFM96W7.SCK, U8.17
SCK8: J52.3, RFM96W8.SCK, U9.17
SCL: J1.4, J2.4, J3.4, R2.1, U1.28
SCL1: J6.4, J8.4, J9.4, R7.1, U2.28
SCL2: J13.4, J14.4, J15.4, R12.1, U3.28
SCL3: J19.4, J20.4, J21.4, R17.1, U4.28
SCL4: J25.4, J26.4, J27.4, R22.1, U5.28
SCL5: J31.4, J32.4, J33.4, R27.1, U6.28
SCL6: J37.4, J38.4, J39.4, R32.1, U7.28
SCL7: J43.4, J44.4, J45.4, R37.1, U8.28
SCL8: J49.4, J50.4, J51.4, R42.1, U9.28
SDA: J1.3, J2.3, J3.3, R3.1, U1.27
SDA1: J6.3, J8.3, J9.3, R8.1, U2.27
SDA2: J13.3, J14.3, J15.3, R13.1, U3.27
SDA3: J19.3, J20.3, J21.3, R18.1, U4.27
SDA4: J25.3, J26.3, J27.3, R23.1, U5.27
SDA5: J31.3, J32.3, J33.3, R28.1, U6.27
SDA6: J37.3, J38.3, J39.3, R33.1, U7.27
SDA7: J43.3, J44.3, J45.3, R38.1, U8.27
SDA8: J49.3, J50.3, J51.3, R43.1, U9.27
TXO: J7.2, U1.31
TXO1: J12.2, U2.31
TXO2: J18.2, U3.31
TXO3: J24.2, U4.31
TXO4: J30.2, U5.31
TXO5: J36.2, U6.31
TXO6: J42.2, U7.31
TXO7: J48.2, U8.31
TXO8: J54.2, U9.31
