sparkfunX/Qwiic_RF/Hardware/Antennas/Compiled/Compiled_Antenna_Test.brd

## EAGLE design Hardware/Antennas/Compiled/Compiled_Antenna_Test.brd (2018-04-12)

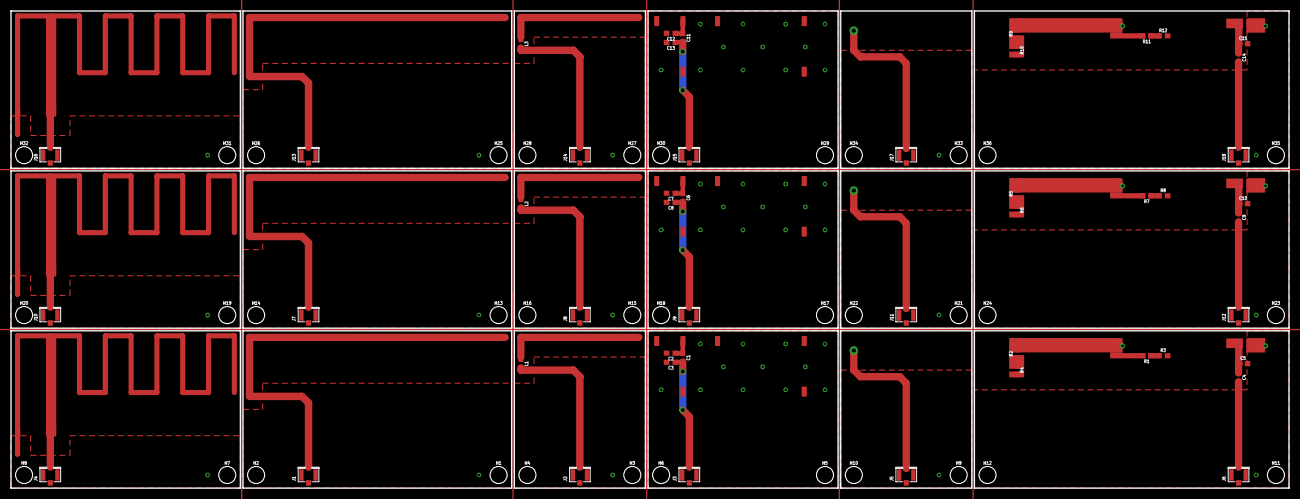
[picture p19: board Compiled_Antenna_Test.brd from above]

Board: 2 copper layers, 247.7 x 92.5 mm, 93 parts (0 on the bottom side), 45 nets.

Parts:
C1, C4, C6, C9, C11, C14: 4.7pF; 0603
C2, C3, C5, C7, C8, C10, C12, C13, C15: 1.0pF; 0603
H1, H2, H3, H4, H5, H6, H7, H8, H9, H10, H11, H12, H13, H14, H15, H16, H17, H18, H19, H20, H21, H22, H23, H24, H25, H26, H27, H28, H29, H30, H31, H32, H33, H34, H35, H36: STAND-OFF
J1, J2, J3, J4, J5, J6, J7, J8, J9, J10, J11, J12, J13, J14, J15, J16, J17, J18: U.FL
L1, L2, L3: 33nH/±5%/500mA; 0603
R1, R2, R3, R4, R5, R6, R7, R8, R9, R10, R11, R12: 0; 0603
U$1, U$4, U$7: ONBOARD_SMD_STAMPED
U$2, U$5, U$8: ANTENNA_915MHZ_INVERTED_F; ANTENNA_INVERTED_F_915MHZ
U$3, U$6, U$9: ETHERTRONICS_STAMPED_ANTENNA; ETHERTRONICS_ISM_STAMPED

Connections:
FEED1: J2.FEED, L1.2
FEED2: C1.1, C2.1, U$1.FEED
FEED3: J4.FEED, U$2.FEED
FEED5: C4.1, C5.1, U$3.FEED
FEED7: J8.FEED, L2.2
FEED8: C6.1, C7.1, U$4.FEED
FEED9: J10.FEED, U$5.FEED
FEED11: C9.1, C10.1, U$6.FEED
FEED13: J14.FEED, L3.2
FEED14: C11.1, C12.1, U$7.FEED
FEED15: J16.FEED, U$8.FEED
FEED17: C14.1, C15.1, U$9.FEED
GND: J1.1, J1.2
GND1: J2.1, J2.2
GND2: C2.2, C3.2, J3.1, J3.2, U$1.GND
GND3: J4.1, J4.2, U$2.GND
GND4: J5.1, J5.2
GND5: C5.2, J6.1, J6.2, U$3.GND
GND6: J7.1, J7.2
GND7: J8.1, J8.2
GND8: C7.2, C8.2, J9.1, J9.2, U$4.GND
GND9: J10.1, J10.2, U$5.GND
GND10: J11.1, J11.2
GND11: C10.2, J12.1, J12.2, U$6.GND
GND12: J13.1, J13.2
GND13: J14.1, J14.2
GND14: C12.2, C13.2, J15.1, J15.2, U$7.GND
GND15: J16.1, J16.2, U$8.GND
GND16: J17.1, J17.2
GND17: C15.2, J18.1, J18.2, U$9.GND
unnamed: C1.2, C3.1, J3.FEED
unnamed: C4.2, J6.FEED
unnamed: R2.1, R4.1
unnamed: R1.1, R3.1
unnamed: C6.2, C8.1, J9.FEED
unnamed: C9.2, J12.FEED
unnamed: R5.1, R6.1
unnamed: R7.1, R8.1
unnamed: C11.2, C13.1, J15.FEED
unnamed: C14.2, J18.FEED
unnamed: R9.1, R10.1
unnamed: R11.1, R12.1
STRIP1: R1.2, R4.2
STRIP3: R6.2, R7.2
STRIP5: R10.2, R11.2
