sparkfunX/Qwiic_RF/(commit log)

2018-04-12 Moving Prototypes into repo from local folder
    [Compiled_Antenna_Test.brd, EthertronicsStampedMetal_Antenna.brd, Helical_Antenna.brd, Helical_Antenna.sch, InvertedF_Antenna.brd, InvertedF_Antenna.sch, OnBoardStampedMetal_Antenna.brd, OnBoardStampedMetal_Antenna.sch]
2018-05-10 x02
    - Trim Antenna
    - Silkscreen Changes to Comply with Semtech TM Requirements
    - Adjust Mounting Holse to Mount to Qwiic Shield + Arduino R3
    - Route DIO1 and DIO2 from RFM95
    - Add Serial Debug Testpoints
    - Add DNP for Shunt Components
    - Add GND Leg Landing for Antenna Footprint
    [Qwiic_LoRa-Panel.GBL, Qwiic_LoRa-Panel.GBO, Qwiic_LoRa-Panel.GBS, Qwiic_LoRa-Panel.GKO, Qwiic_LoRa-Panel.GTL, Qwiic_LoRa-Panel.GTO, Qwiic_LoRa-Panel.GTP, Qwiic_LoRa-Panel.GTS]
2018-05-29 Begin implementing "reliable send"
    //TODO
    //Load Settings from EEPROM
    //Reliable send verification routine
    // x Add reliable send flag to message packet
    // o Respond to reliable flag with sum%255 of lastRecieved
    // o Check all reponses from reliable wait status set to end of
    // ack timer for sum%255 of lastRecieved
2018-05-29 Meta Commit
    Typo in TODO
    // o Respond to reliable flag with checksum%255 of lastRecieved
    // ack timer for checksum%255 of lastSent
    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
2018-05-30 Close to Finishing Firmware 🤞
    //Global Cleanup
    //Pairing Sequence
    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
2018-06-19 I2C Pairing is Functional
2018-06-28 Version X03
    Add Chip Select pullup on the radio module, only affects programming.
    [Qwiic_LoRa-Panel.GBL, Qwiic_LoRa-Panel.GBO, Qwiic_LoRa-Panel.GBS, Qwiic_LoRa-Panel.GKO, Qwiic_LoRa-Panel.GTL, Qwiic_LoRa-Panel.GTO, Qwiic_LoRa-Panel.GTP, Qwiic_LoRa-Panel.GTS]
